freitas-renato/PSI3214/README.md

# PSI3214 - Laboratório de instrumenetação elétrica

- etapa2: VI feito até agora
- assets: programas pro Arduino
- circuito: esquemático
- coisas do lab: coisas roubadas do lab
- relatorio_2: pdf relatório 2
