freitas-renato/PSI3214/relatorio_2/relatorio_2.pdf

ESCOLA POLITÉCNICA DA UNIVERSIDADE DE SÃO PAULO


PSI-3214 - Laboratório de Instrumentação Elétrica


Turma 5 - Grupo 5

Filipe Gabriel Santos | 9837761
Renato de Oliveira Freitas | 9837708
Tamy Beatriz Miyano | 9837563

### 4 de novembro de 2017

## Sumário

1 Introdução | 1
2 Projeto | 2
3 Resultados | 9
4 Conclusão | 10

1

Resumo

Ondas sonoras consistem em vibrações mecânicas de um meio natural e se propagam com uma velocidade que depende de diversos fatores, entre eles a natureza do meio.
Nota musical é um termo empregado para designar o elemento mínimo de um som, formado por um único modo de vibração do ar. Sendo assim, a cada nota corresponde uma duração e está associada uma frequência. Apesar de diferentes, quando os instrumentos reproduzem uma mesma nota, o som é agradável. Isso acontece pois todas as componentes dessa melodia são compostas por múltiplos inteiros da frequência original. Para entender melhor esse conceito podemos analisar a tabela ao lado, que relaciona as notas e suas respectivas frequências: A nota dó (C) corresponde a frequência de 261,63 Hz, enquanto a nota sol (G) é aproximadamente 392 Hz, que é 3/2 a frequência do dó. [1]
Outro fator importante para diferenciar os sons é a amplitude de cada harmônica, ou seja, sua intensidade. Existem instrumentos em que algumas harmônicas têm amplitudes superiores a própria frequência fundamental, tornando o som bem mais grave ou agudo. Matematicamente, representa-se o espectro sonoro como uma série de Fourier, uma função no domínio das frequências, em oposição à forma de onda que é uma função no domínio do tempo. Qualquer onda sonora, assim como qualquer outro fenômeno ondulatório, pode ser representado através de seu espectro. Um gráfico de espectro sonoro é composto de barras, cada uma delas representando a amplitude de uma das frequências componentes do som analisado. Este tipo de gráfico é utilizado em equipamentos eletrônicos, tais como analisadores de espectro ou em equalizadores. No caso dos analisadores digitais, o cálculo é realizado através da Transformada Rápida de Fourier - FFT (Fast Fourier Transform), um algoritmo bastante eficiente que permite calcular o valor de uma transformada discreta de Fourier, em tempo real. [2]
Com base nisso, o projeto consiste em desenvolver um detector de notas musicais utilizando sensores acoplados ao condicionador de sinais, conversor AD e software de monitoramento, no caso, o LabVIEW [3], capaz de identificar uma sequência de 5 notas musicais monofônicas.

## 1 Introdução

O projeto de 2017 da disciplina do Laboratório de Instrumentação Elétrica tem como tema o desenvolvimento de um instrumento virtual de monitoramento capaz de adquirir, processar e visualizar graficamente sinais de sensores. O objetivo deste projeto é que, ao longo do semestre, o grupo aplique os conhecimentos adquiridos em aula para a composição do sistema.
O grupo deverá desenvolver um produto que, com o uso de microcontroladores, transfira leituras analógicas para uma unidade de processamento digital, como um PC, e aplique as transformações de Fourier e outrar ferramentas matemáticas.
Será utilizado um teclado arranjador, cujas notas serão transmitidas ao circuito de condicionamento. O sinal obtido pelo circuito será adquirido pelo microcontrolador, no caso, o Arduino UNO, e processado para que o programa LabVIEW o leia e apresente uma interface gráfica. Abaixo, apresenta-se um diagrama com os elementos do sistema:


Figura 1: Diagrama de blocos dos elementos do sistema

1

## 2 Projeto

### 2.1 Aquisição de sinais

Neste item, é descrito como o som do teclado será adiquirido e processado pelo Arduino. Para a composição do sistema, foram utilizados os componentes listados abaixo:

- Amplificador Operacional LM 741
- Duas baterias de 9V
- Dois conectores para baterias de 9V
- Potenciômetro de 10kΩ
- Três resistores de 100kΩ
- Capacitor eletrolítico de10µF
- Capacitor cerâmico de 47nF
- Arduino UNO
- Protoboard
- Cabo P10-P2
- Plug fêmea P2

Um sinal de áudio é composto por milhões de pequenas oscilações. Quando relacionado à eletrônica, essas oscilações representam tensões oscilatórias.
Quando um sinal de áudio é observado no osciloscópio, é possível notar que a onda oscila em volta da linha de 0V. A amplitude de um sinal de áudio é a distância entre a tensão central e o pico mais alto, ou mais baixo. Por exemplo, num osciloscópio, se a amplitude for de 3V, o máximo será +3V e o mínimo, -3V. O problema é que o Arduino só consegue medir tensões entre 0 e 5V. Se for realizada uma medição de tensão abaixo de 0V, a parte negativa da onda seria cortada. Portanto, idealmente, seria necessário buscar obter uma onda de amplitude 2,5V que oscile por volta de 2,5V.
Sinais gerados por instrumentos musicais são obtidos com amplitudes muito baixas, por isso precisam ser amplificadas para a amplitude desejada, no caso, 2,5V, com um aplificador operacional.
Entretanto, o centro da onda de tensão ainda estará em 0V e, para corrigir esse problema, o offset deverá ser alterado. Assim, colocando um offset de 5V no Arduino, o centro de tensão será 2,5V ao invés de 0V, e então a onda não cairá abaixo de 0V.

2


Figura 2: Circuito de condicionamento com amp op e offset de 5V

Para obter o sinal de áudio do instrumento, foi utilizado um cabo macho P10-P2 e um plug P2 fêmea para a conexão no circuito.


Figura 3: Cabo P10 - P2

Além disso, serão utilizadas duas baterias de 9V conectadas em série para criar uma alimentação simétrica de +9V e -9V. As alimentações positiva e negativa serão então conectadas no amp op. O sinal obtido da fonte de áudio pelo cabo é ligado à entrada não inversora. Da junção das baterias de 9V em série, faz-se uma ligação ao terra. Para a realimentação, coloca-se um

3

resistor de 100kΩ entre a saída e a entrada inversora do amp op. Para ajustar o ganho do amp op, será utilizado um potenciômetro de 10kΩ
A seguinte equação descreve a relação entre a amplitude do sinal antes e depois de passar pelo amp op:

Vout

Vin

≈ 1 +

R2
R1

(1)

No caso, R2 = 100kΩ e 0 ≤ R1 ≤ 10kΩ. Ajustando o potenciômetro, é possível ajustar o ganho de amplificação.
O circuito DC offset tem um divisor de tensão e um capacitor. O divisor de tensão possui dois resistores de 100kΩ em série que ligam a alimentação de 5V do Arduino ao terra. Como os resistores têm as mesmas resistências, a tensão na junção entre eles é igual a 2,5V. Essa junção de 2,5V é ligada à saída do amp op através de um capacitor de 10µF. Como a tensão no lado do amp op aumenta e diminui, isso faz com que a carga acumule momentaneamente e seja repelida para o lado do capacitor conectado à junção de 2,5V. Isso faz com que a tensão na junção de 2,5V oscile centrada em 2,5V, para cima e para baixo.


Figura 4: Ilustração do circuito montado na protoboard

Para realizar a comunicação entre o Arduino e o LabVIEW, foi utilizada a extensão LINX[4], que controla a comunicação serial com o Arduino. Na inicialização do programa no LabVIEW, é selecionada a porta serial USB que está conectada ao Arduino e cria-se um vetor novo vazio com tamanho especificado.

4

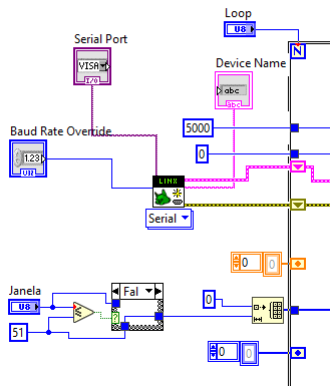
[picture p28: figure]

Figura 5: Inicialização da comunicação em LabVIEW

Em seguida, vem o laço principal, que faz a aquisição de sinais. Após o programa ser inicializado e ter sido estabelecido uma comunicação entre o LabVIEW e o Arduino, uma função de comando personalizado é chamada e forma-se um vetor com o tamanho especificado, como foi descrito anteriormente. O primeiro valor do vetor será o tempo total gasto para realização da medida. O restante são os valores de 8 bits, que variam de 0 a 255. Para que esses valores sejam convertidos para uma onda de amplitude 5V centrada em 0V, subtrai-se 130 dos valores do vetor. Multiplicando por 0,02, o valor máximo do vetor (255−130 = 125) será igual a 2,5V, que é amplitude máxima desejada da representação gráfica da onda.

5


Figura 6: Laço principal do programa em LabVIEW

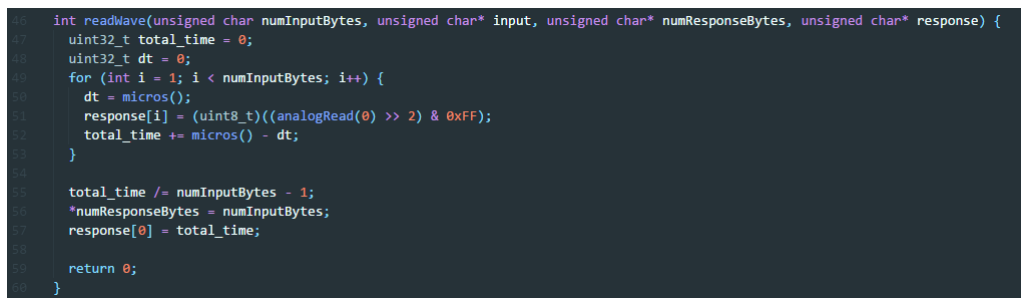
[picture p29: figure]

Figura 7: Código da função de comando personalizado

### 2.2 Transformada Discreta de Fourier

Após a aquisição e processamento, os pontos obtidos para reproduzir a forma de onda original são passados para um outro diagrama de blocos que realiza a Transformada Discreta de Fourier, que tem como saída dois outros vetores que correspondem à magnitude e fase (fasores na forma polar) do sinal original.
A janela de aquisição é a mesma do início do programa, ou seja, a quantidade de pontos para o cálculo da transformada será o mesma dos pontos adquiridos desde o início.
Nesta etapa, somente o resultado das frequências foi utilizada para a separação dos elementos da série de Fourier que forma o sinal de áudio original. Esses resultados são utilizados para formar o gráfico do sinal no domínio das frequências.
É calculada também a frequência predominante após a análise, ignorando frequências resultantes de ruídos muito pequenos (amplitudes menores que 0,2 Hz), mostrada numericamente na tela principal do VI.

6

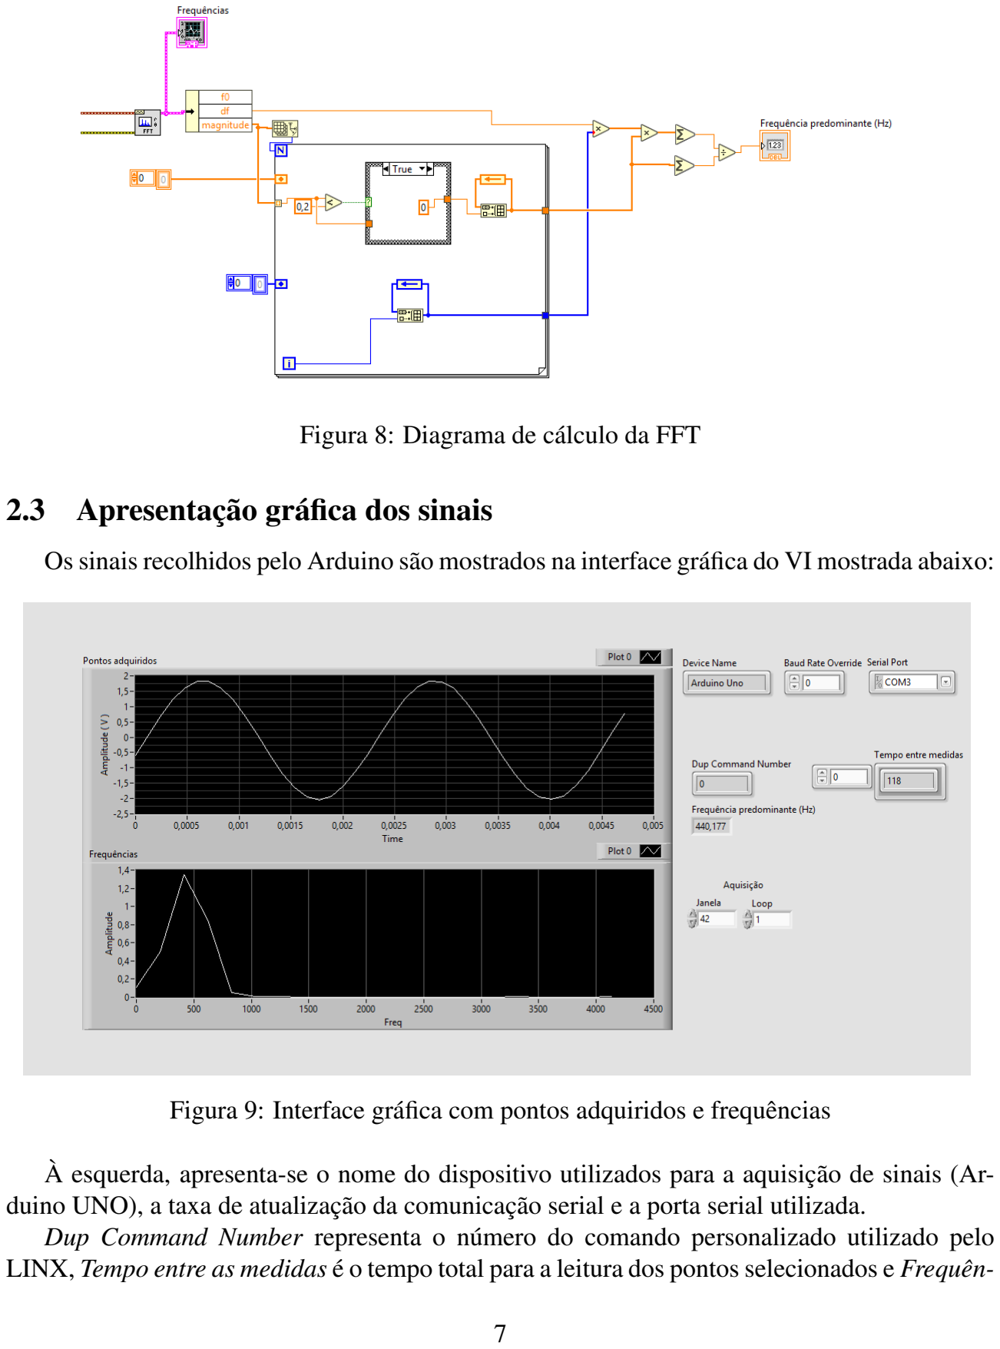
[picture p30: page 10]

Figura 8: Diagrama de cálculo da FFT

### 2.3 Apresentação gráfica dos sinais

Os sinais recolhidos pelo Arduino são mostrados na interface gráfica do VI mostrada abaixo:

Figura 9: Interface gráfica com pontos adquiridos e frequências

À esquerda, apresenta-se o nome do dispositivo utilizados para a aquisição de sinais (Arduino UNO), a taxa de atualização da comunicação serial e a porta serial utilizada.
Dup Command Number representa o número do comando personalizado utilizado pelo LINX, Tempo entre as medidas é o tempo total para a leitura dos pontos selecionados e Frequên-

7

cia predominante (Hz) mostra a frequência fundamental dos espectros de Fourier.
O primeiro gráfico é resultado da quantidade de pontos selecionada previamente no campo Janela, enquanto o segundo mostra o sinal no domínio das frequências após a Transformada de Fourier.
A interface ainda é experimental, uma vez que o grupo teve, inicialmente, problemas ao adquirir dados pelo VI. Houve problemas com a aquisição da forma de onda de maneira correta, havendo muitas oscilações indesejadas e sinais resultantes ruidosos. Resolvida a situação, o grupo ainda não foi capaz de desenvolver a interface completa, deixando-a para a terceira etapa. Agora, a interface adquire apenas o número de pontos especificados no começo, e não continuamente - ou seja, o grupo contornou o problema inicial de maneira mais inteligente. Para as escalas horizontais e verticais, a função automática foi desativada, fixando a vertical entre -2,5V e 2,5V com intervalos de 0,5V, e a horizontal, o tempo, varia de acordo com a necessidade.

8

## 3 Resultados

Até agora, os resultados do projeto foram satisfatórios, respeitando uma margem de erro aceitável. Como foi utilizado um gerador que fornece sinais de áudio sem ruídos e de frequências contínuas ("perfeitos"), as ondas obtidas em gráficos foram previsíveis e de fácil manipulação.
Na imagem anterior, a onda original gerada possuía 440Hz (nota A4) de frequência. Após análise, o sistema foi capaz de processar o sinal de maneira satisfatória, obtendo um resultado muito próximo ao original. O mesmo pode-se observar para um teste com uma onda de 660Hz (nota E5):


Figura 10: Análise da nota E5 - 660Hz

9

## 4 Conclusão

Essa segunda etapa de projeto mostrou-se complicada na medida em que exigiu-se mais afinidade com o programa LabVIEW, além de buscar extensões de comunicação com a plataforma Arduino UNO utilizada no projeto.
Para que fosse feita essa etapa, o grupo teve que adquirir todos os componentes necessários para a montagem do sistema. Alguns componentes foram fornecidos pela própria disciplina, outros são de posse dos próprios integrantes do grupo. Os testes que foram realizados durante as sessões de OpenLab foram fundamentais para as análises dos sinais e gráficos obtidos. Houve bastante dificuldade em solucionar alguns problemas, mas foram resolvidos após mais pesquisas e conselhos.
Os resultados foram positivos para esta segunda etapa, considerando que utilizamos uma fonte de sinal contínua e sem ruídos. Para a próxima etapa, será preciso aperfeiçoar o sistema para que a frequência adquirida tenha uma desvio menor possível em relação ao esperado.

10

## Referências

[1] Wikipedia, “Nota.” https://pt.wikipedia.org/wiki/Nota.
[2] Wikipédia, “Espectro sonoro.” https://pt.wikipedia.org/wiki/Espectro_sonoro.
[3] N. | Instruments, | “National | instruments | labview.” | http://www.ni.com/pt-
br/shop/labview.html.
[4] N. Instruments, “Labview makerhub linx.” https://www.labviewmakerhub.com.

11
