freitas-renato/PSI3214/relatorio_2/imagens/if_music-note-sound_353429.png

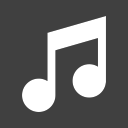
relatorio_2/imagens/if_music-note-sound_353429.png
