freitas-renato/PSI3214/(list of files, drawings)

Other design files:
circuito/circuito.ms14
circuito/desenho esquematico.fzz
