freitas-renato/PSI3214/assets/ArduinoLabVIEW_LINX/ArduinoLabVIEW_LINX.ino

/****************************************************************************************	
**  This is example LINX firmware for use with the Arduino Uno with the serial 
**  interface enabled.
**
**  For more information see:           www.labviewmakerhub.com/linx
**  For support visit the forums at:    www.labviewmakerhub.com/forums/linx
**  
**  Written By Sam Kristoff
**
**  BSD2 License.
****************************************************************************************/

//Include All Peripheral Libraries Used By LINX
#include <SPI.h>
#include <Wire.h>
#include <EEPROM.h>
#include <Servo.h>

//Include Device Specific Header From Sketch>>Import Library (In This Case LinxChipkitMax32.h)
//Also Include Desired LINX Listener From Sketch>>Import Library (In This Case LinxSerialListener.h)
#include <LinxArduinoUno.h>
#include <LinxSerialListener.h>
 
//Create A Pointer To The LINX Device Object We Instantiate In Setup()
LinxArduinoUno* LinxDevice;

//Initialize LINX Device And Listener
void setup()
{
  //Instantiate The LINX Device
  LinxDevice = new LinxArduinoUno();
  
  //The LINXT Listener Is Pre Instantiated, Call Start And Pass A Pointer To The LINX Device And The UART Channel To Listen On
  LinxSerialConnection.Start(LinxDevice, 0);  
}

void loop()
{
  //Listen For New Packets From LabVIEW
  LinxSerialConnection.CheckForCommands();
  
  //Your Code Here, But It will Slow Down The Connection With LabVIEW
  LinxSerialConnection.AttachCustomCommand(0, readWave);
}

int readWave(unsigned char numInputBytes, unsigned char* input, unsigned char* numResponseBytes, unsigned char* response) {
  uint32_t total_time = 0;
  uint32_t dt = 0;
  for (int i = 1; i < numInputBytes; i++) {
    dt = micros();
    response[i] = (uint8_t)((analogRead(0) >> 2) & 0xFF);
    total_time += micros() - dt;
  }

  total_time /= numInputBytes - 1;
  *numResponseBytes = numInputBytes;
  response[0] = total_time;

  return 0;
}
