freitas-renato/PSI3214/(commit log)

2017-11-01 :construction: Tudo feito ate agora
    [circuito.ms14]
2017-11-04 :art: Add esquematico
    [desenho esquematico.fzz]
